pablintino/AnalogIO-CAN-HW/Fabrication/Schematic Print/Schematic Prints.PDF

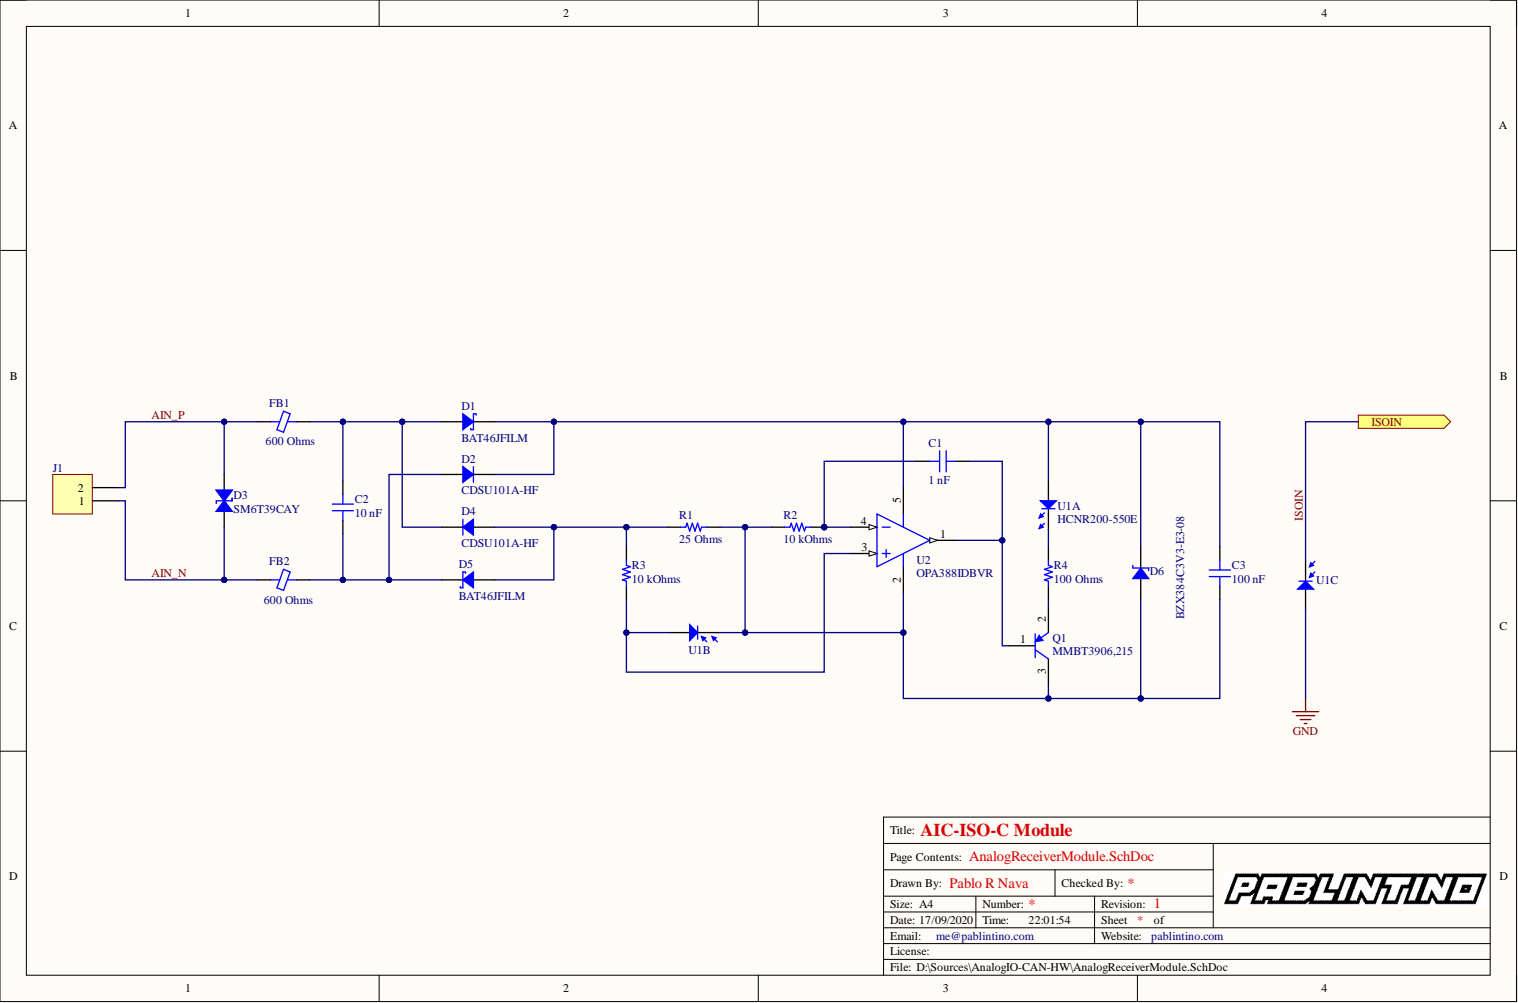
[picture p1: page 1]

Draw n By : P a blo R Na v a | Checked By : *
Size: A 4 | * N u mber: | 1 Rev i s i o n :

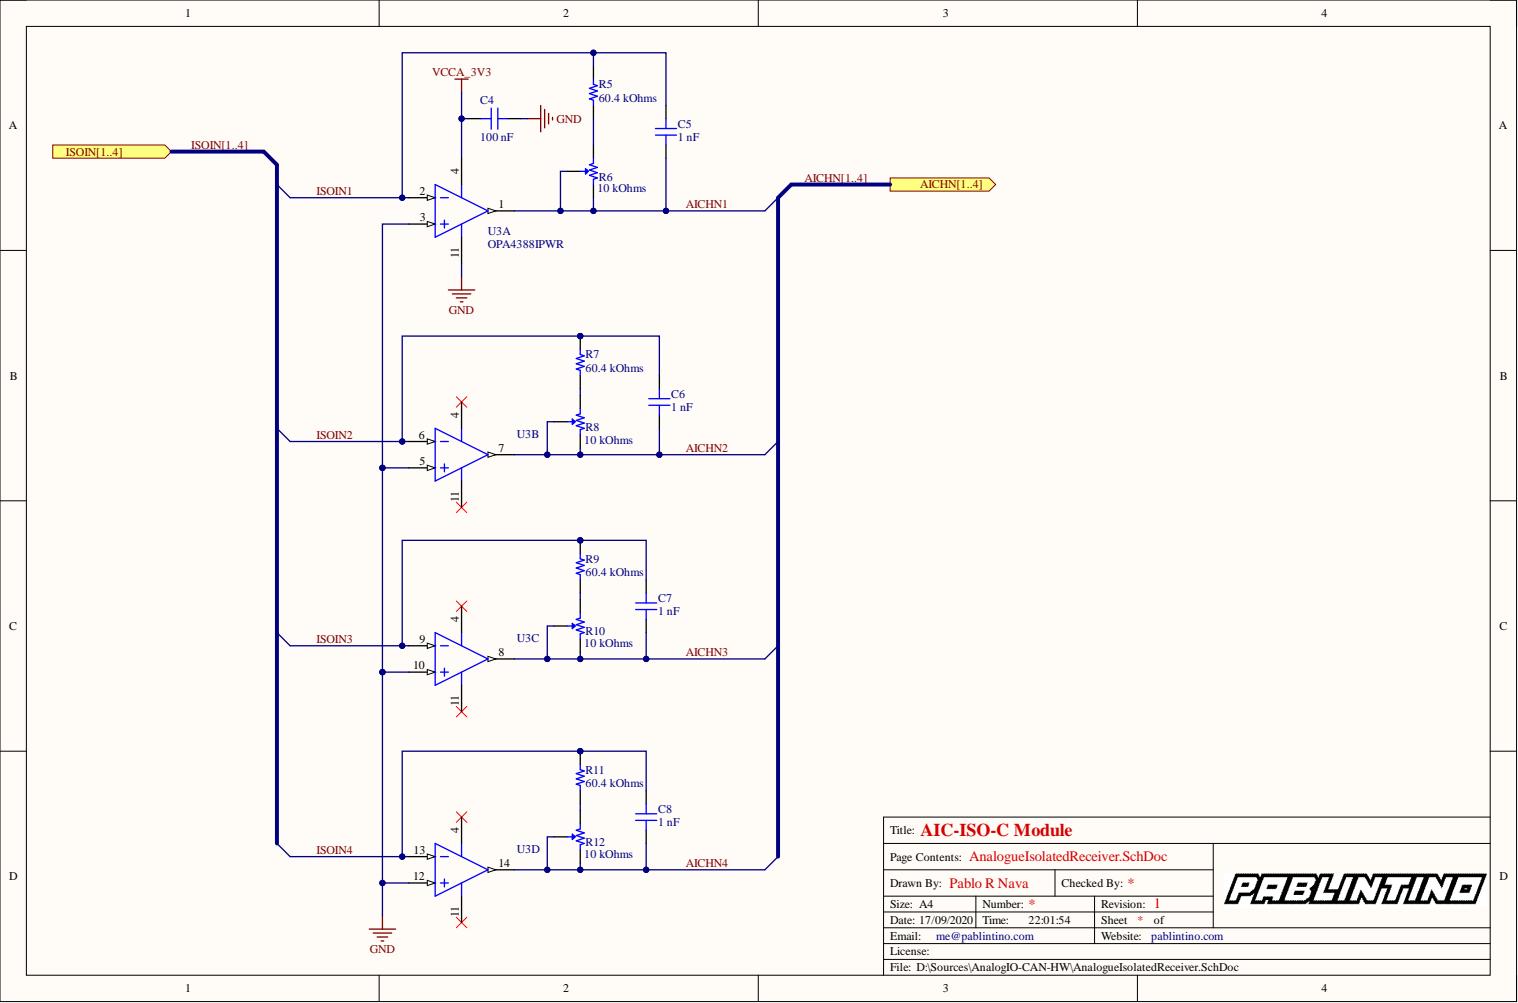
[picture p2: page 2]

Page Contents: AnalogueIsolatedReceiver.SchDoc

Drawn By: Pablo R Nava | Checked By: *
Size: A4 | * Number: | 1 Revision:

License:
D:\Sources\AnalogIO-CAN-HW\AnalogueIsolatedReceiver.SchDoc

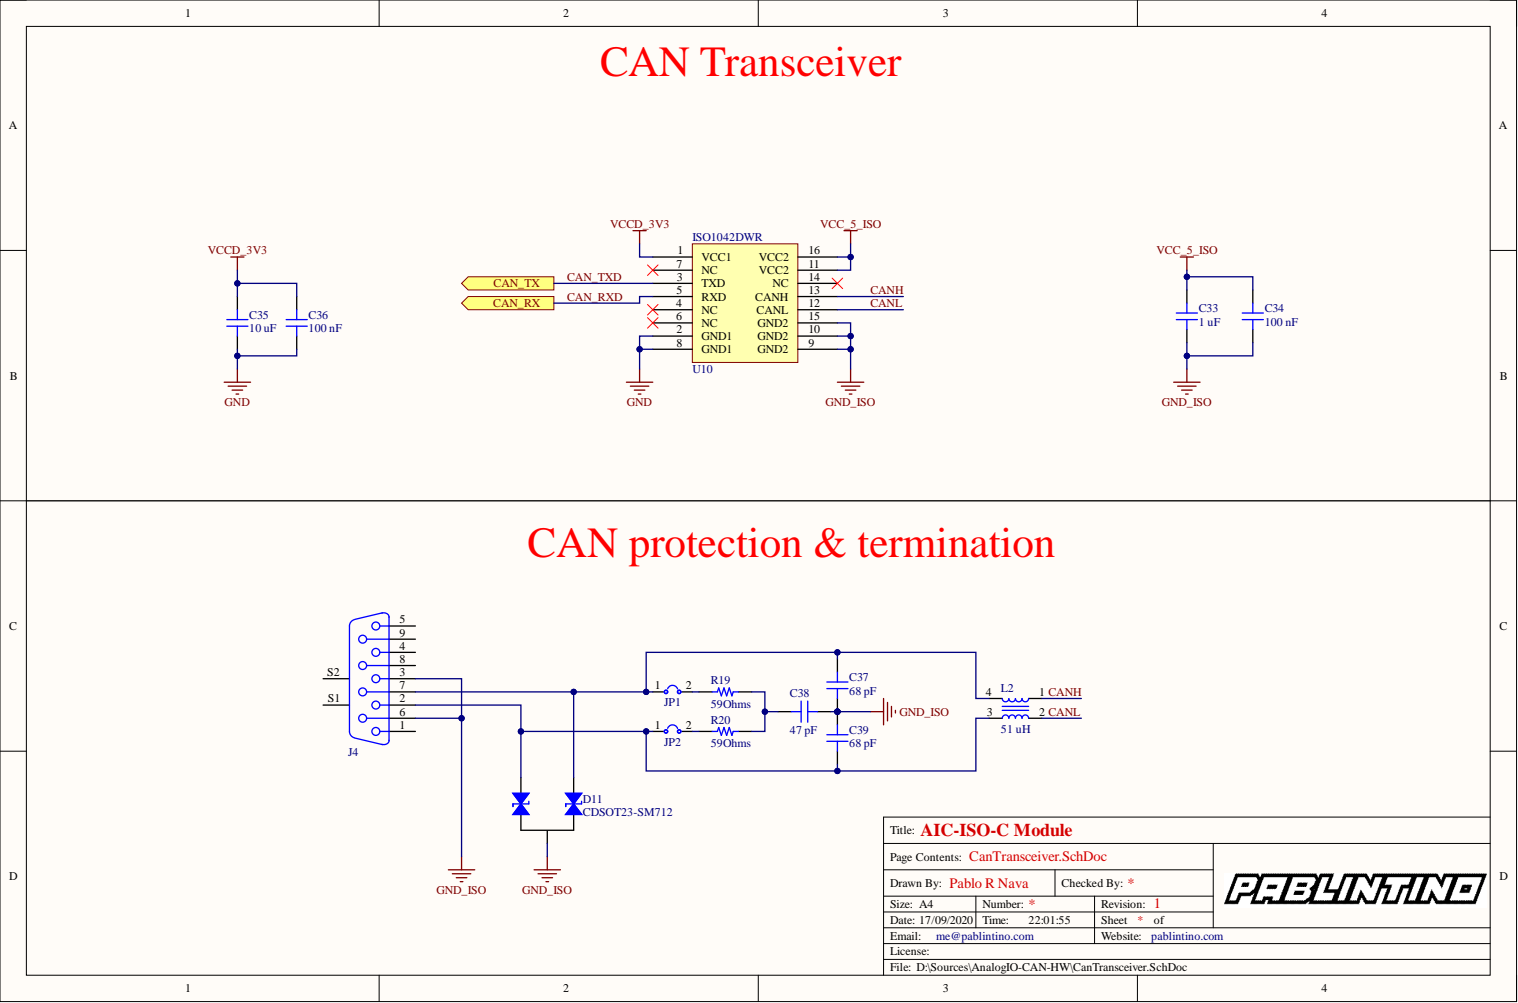
[picture p3: page 3]

JP2 59Ohms

Page Contents: CanTransceiver.SchDoc

Drawn By: Pablo R Nava | Checked By: *
Size: A4 | * Number: | 1 Revision:

D:\Sources\AnalogIO-CAN-HW\CanTransceiver.SchDoc

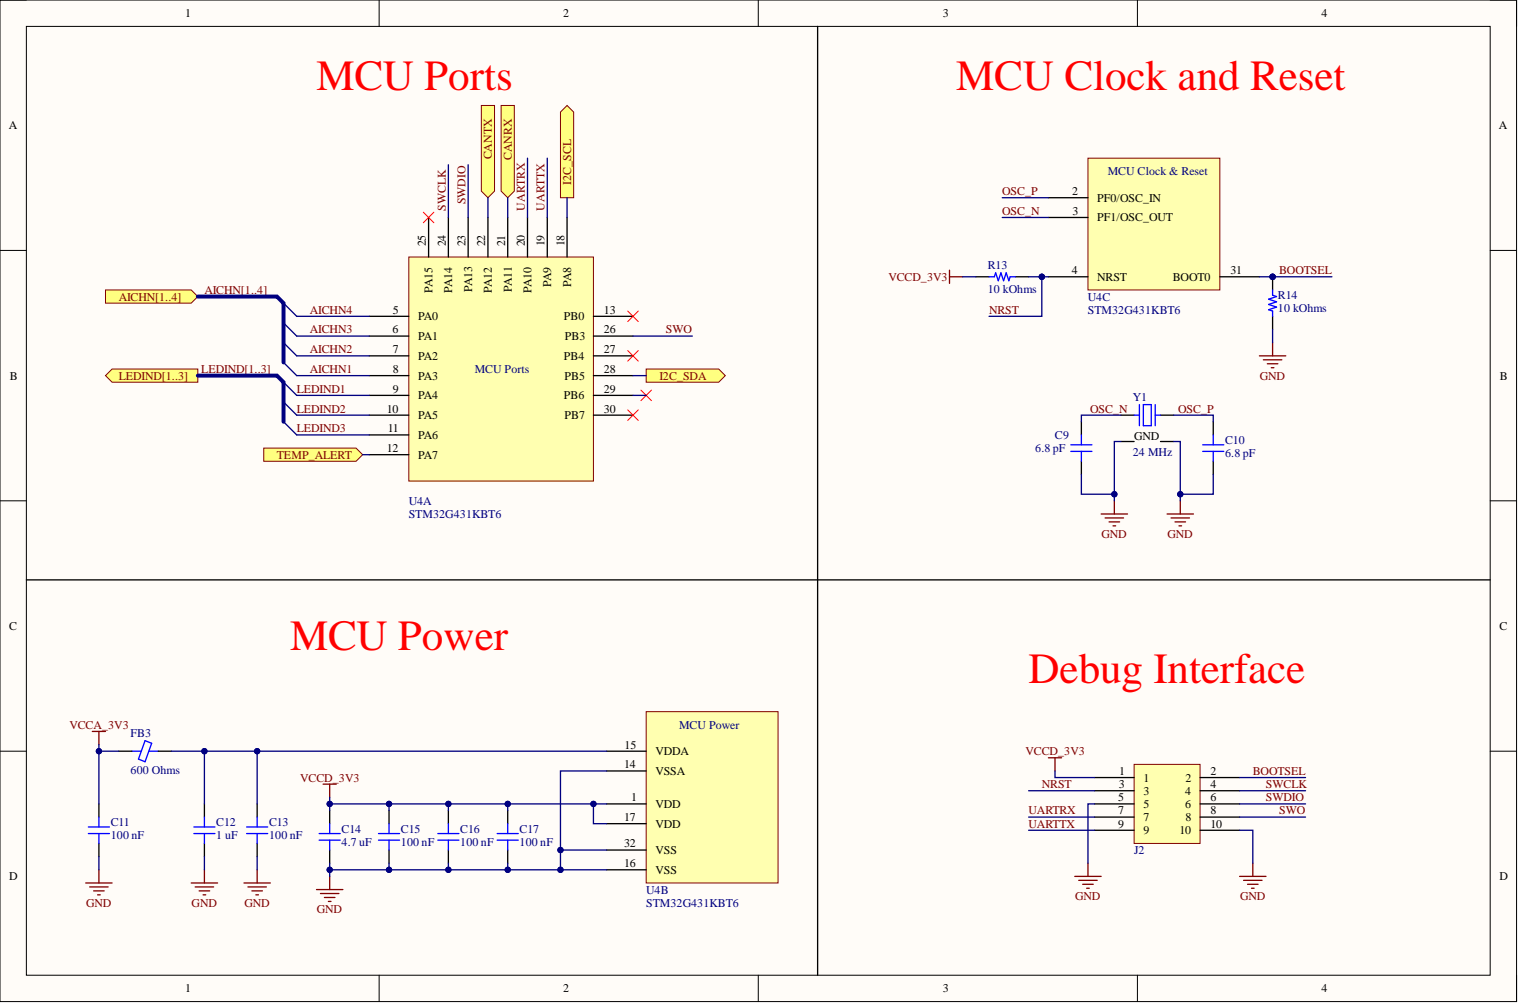
[picture p4: page 4]

MCU Clock and Reset

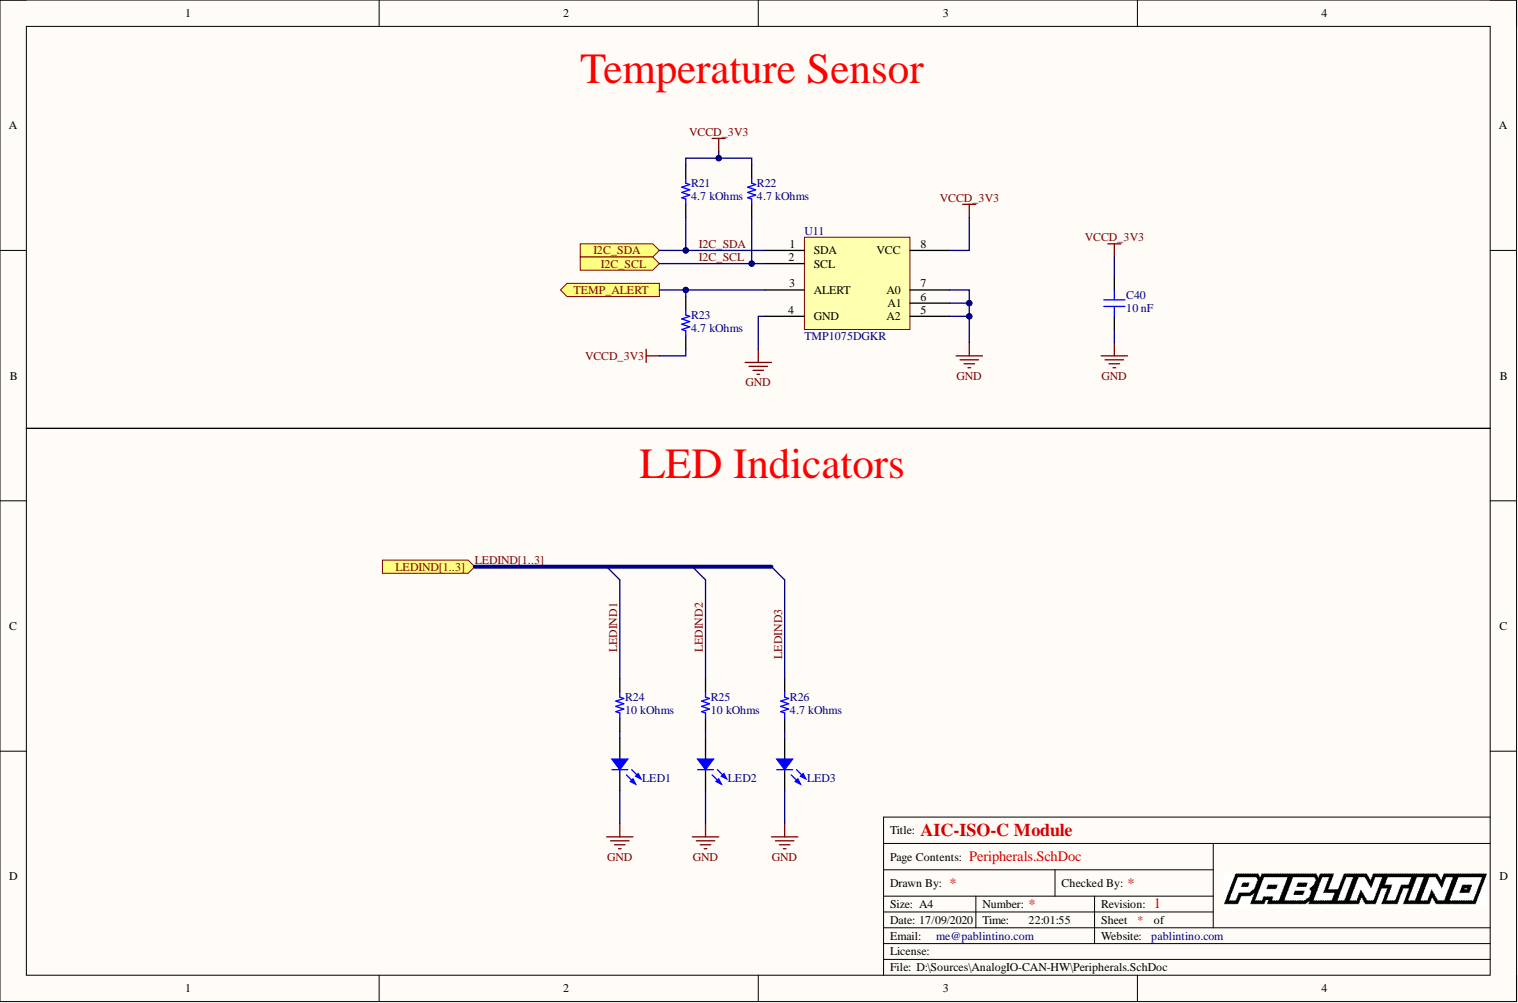
[picture p5: page 5]

Page Contents: Peripherals.SchDoc

Drawn By: * | Checked By: *
Size: A4 | * Number: | 1 Revision:

D:\Sources\AnalogIO-CAN-HW\Peripherals.SchDoc

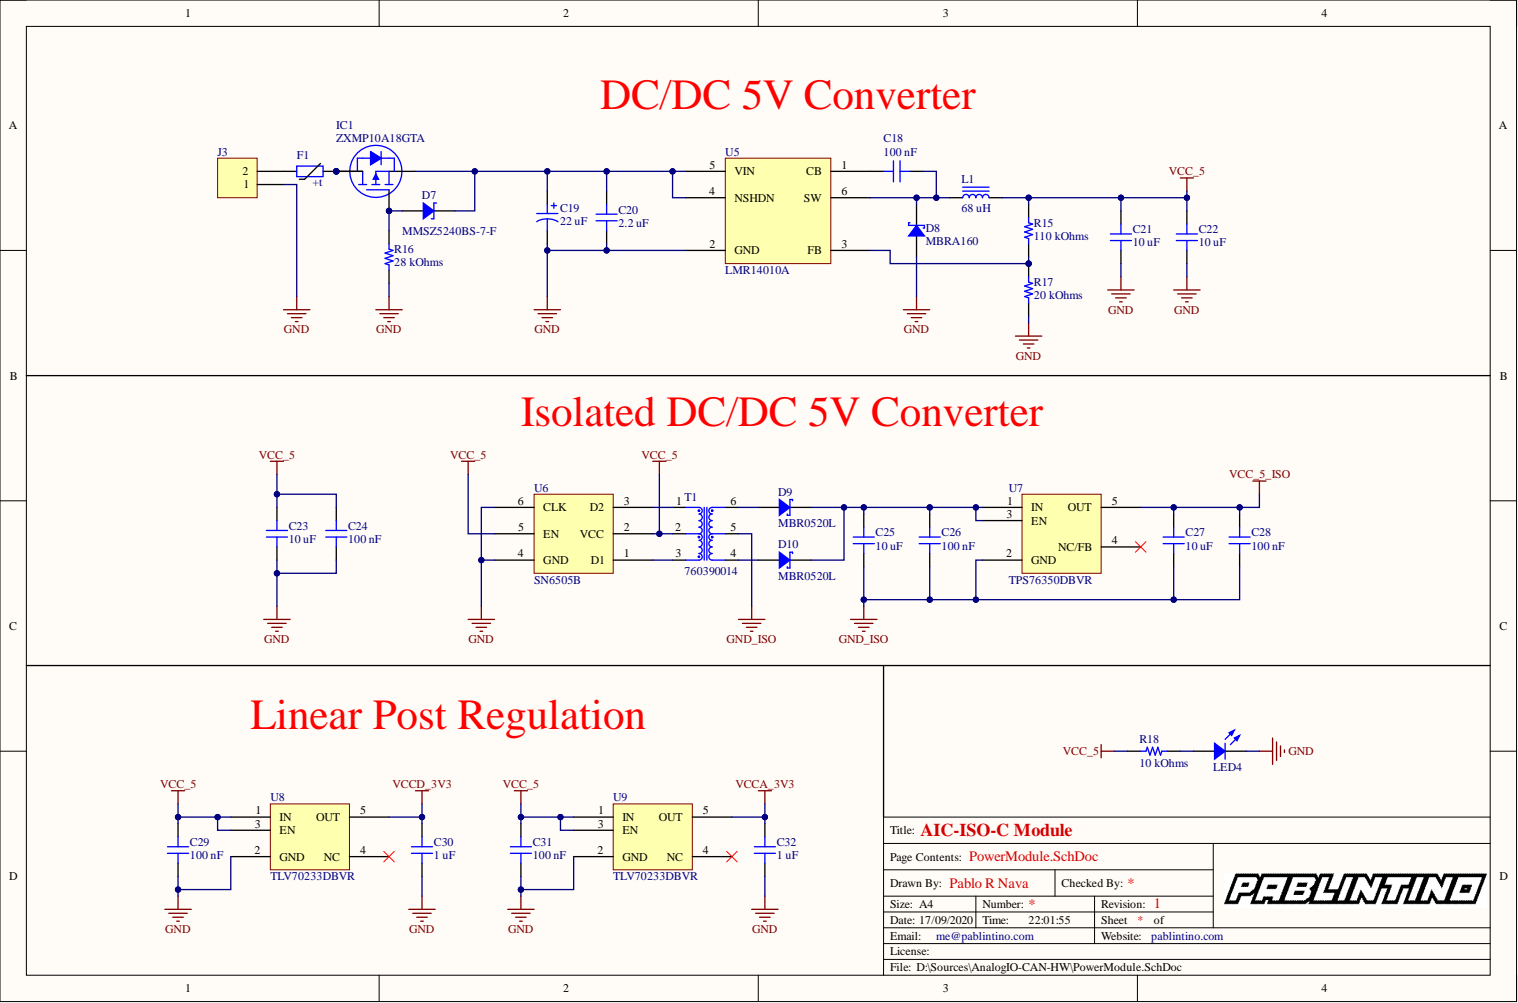
[picture p6: page 6]

GND
Isolated DC/DC 5V Converter

Page Contents: PowerModule.SchDoc

Drawn By: Pablo R Nava | Checked By: *
Size: A4 | * Number: | 1 Revision:

D:\Sources\AnalogIO-CAN-HW\PowerModule.SchDoc

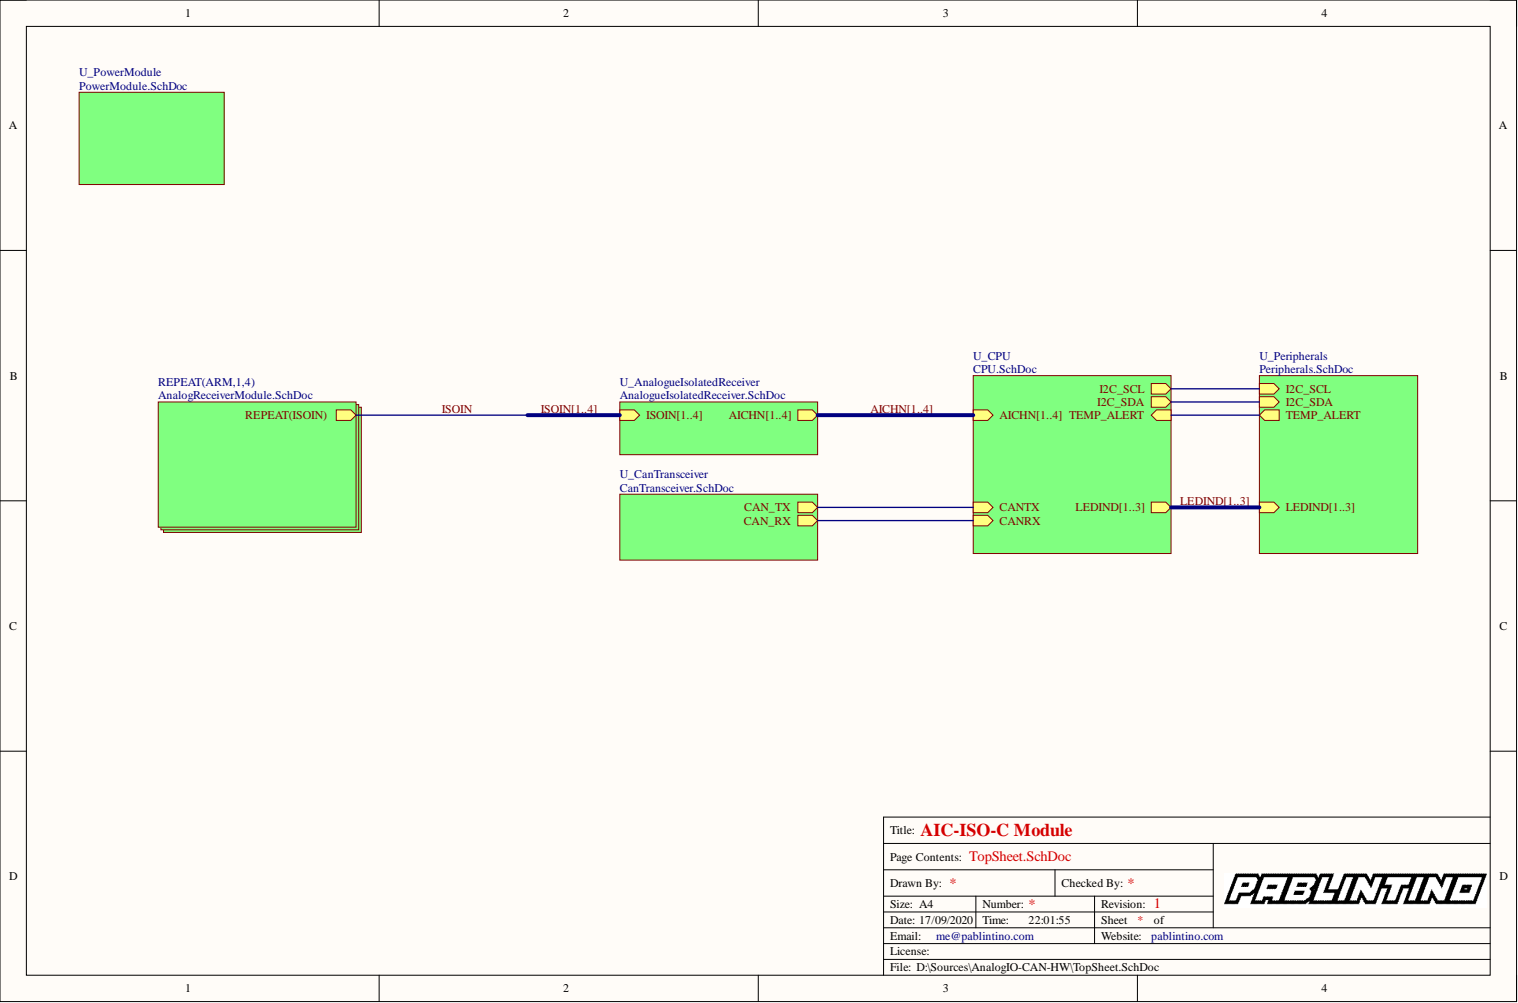
[picture p7: page 7]

Page Contents: TopSheet.SchDoc

Drawn By: * | Checked By: *
Size: A4 | * Number: | 1 Revision:

D:\Sources\AnalogIO-CAN-HW\TopSheet.SchDoc
