pablintino/AnalogIO-CAN-HW/Fabrication/DRC/Design Rules Check.PDF

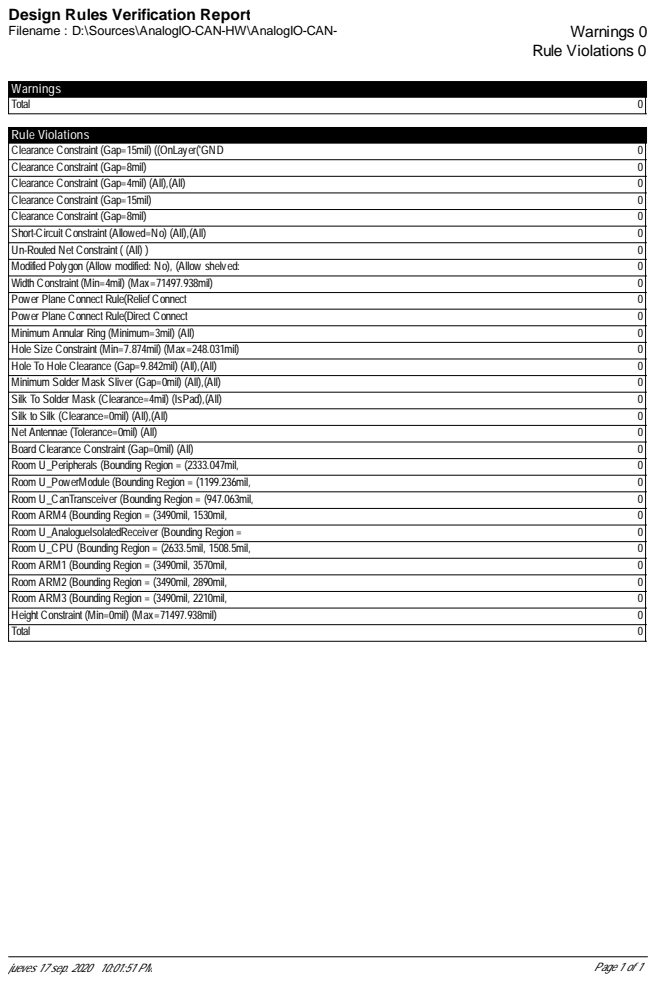
[picture p8: page 1]

Design Rules Verification Report
