pablintino/AnalogIO-CAN-HW/(list of files, drawings)

Other design files:
Altium_prj/AnalogIO-CAN-HW-Rev1.PcbDoc
AnalogReceiverModule.SchDoc
AnalogueIsolatedReceiver.SchDoc
CAN_CurrentLoopModule.PrjPcb
CANCurrentModuleLib.PcbLib
CANCurrentModuleLib.SchLib
CanTransceiver.SchDoc
CPU.SchDoc
Peripherals.SchDoc
PowerModule.SchDoc
TopSheet.SchDoc
