pablintino/AnalogIO-CAN-HW/(commit log)

2020-01-17 + Added first schematics
    [CANCurrentModuleLib.PcbLib, CANCurrentModuleLib.SchLib, CAN_CurrentLoopModule.PrjPcb, ModuleSchema.SchDoc]
2020-01-18 + Added power supply schematic
    [CANCurrentModuleLib.SchLib, ModuleSchema.SchDoc]
2020-01-18 + Added new analog schematic
    [AnalogReceiverModule.SchDoc, CANCurrentModuleLib.SchLib, CAN_CurrentLoopModule.PrjPcb, PowerModule.SchDoc]
2020-01-20 + Added analog current loop channel schematic input protection.
    [AnalogReceiverModule.SchDoc, CANCurrentModuleLib.SchLib, CAN_CurrentLoopModule.PrjPcb, PowerModule.SchDoc]
2020-01-20 + Added input ferrite beads to current sensing module.
    [AnalogReceiverModule.SchDoc, CANCurrentModuleLib.SchLib]
2020-01-25 + Changed VCC 3.3V net name. + Finished analog input circuit.
    [AnalogReceiverModule.SchDoc, AnalogueIsolatedReceiver.SchDoc, PowerModule.SchDoc, TopSheet.SchDoc]
2020-01-30 + Added CAN transceiver.
    [AnalogReceiverModule.SchDoc, CANCurrentModuleLib.SchLib, CAN_CurrentLoopModule.PrjPcb, CanTransceiver.SchDoc]
2020-02-02 + Added first revision of CPU Schematic.
    [CANCurrentModuleLib.SchLib, CPU.SchDoc, CanTransceiver.SchDoc, TopSheet.SchDoc]
2020-02-02 + First try on commponent designation.
    [AnalogReceiverModule.SchDoc, AnalogueIsolatedReceiver.SchDoc, CANCurrentModuleLib.SchLib, CAN_CurrentLoopModule.PrjPcb, CPU.SchDoc, CanTransceiver.SchDoc, Connectors.SchDoc, PowerModule.SchDoc]
2020-02-02 + Second revision of schematic.
    [AnalogReceiverModule.SchDoc, AnalogueIsolatedReceiver.SchDoc, CANCurrentModuleLib.SchLib, CAN_CurrentLoopModule.PrjPcb, CPU.SchDoc, CanTransceiver.SchDoc, PowerModule.SchDoc, TopSheet.SchDoc]
2020-02-02 + Cleanup.
    [Connectors.SchDoc, ModuleSchema.SchDoc]
2020-02-02 + First revision of the schematics that compiles.
    [AnalogReceiverModule.SchDoc, AnalogueIsolatedReceiver.SchDoc, CANCurrentModuleLib.SchLib, CAN_CurrentLoopModule.PrjPcb, CPU.SchDoc, CanTransceiver.SchDoc, PowerModule.SchDoc, TopSheet.SchDoc]
2020-02-02 + Minor name changes.
    [AnalogReceiverModule.SchDoc, TopSheet.SchDoc]
2020-02-06 + Added power schematic values. + Added third party parts with its footprints.
    [AnalogReceiverModule.SchDoc, AnalogueIsolatedReceiver.SchDoc, CANCurrentModuleLib.PcbLib, CPU.SchDoc, CanTransceiver.SchDoc, PowerModule.SchDoc]
2020-02-10 + Changed analog side components and its footprints.
    [AnalogReceiverModule.SchDoc, AnalogueIsolatedReceiver.SchDoc, CANCurrentModuleLib.PcbLib, CANCurrentModuleLib.SchLib, CAN_CurrentLoopModule.PrjPcb, CPU.SchDoc, CanTransceiver.SchDoc, PowerModule.SchDoc]
2020-02-11 + Added last footprints to the analog receiver part. + Changed default resistor values to the final values.
    [AnalogReceiverModule.SchDoc, CAN_CurrentLoopModule.PrjPcb]
2020-02-16 + Updated CAN module to use the new integrated lib symbols and footprints.
    [AnalogueIsolatedReceiver.SchDoc, CANCurrentModuleLib.PcbLib, CANCurrentModuleLib.SchLib, CAN_CurrentLoopModule.PrjPcb, CanTransceiver.SchDoc]
2020-02-16 + Added bypass capacitors to CAN module. + Adjusted termination to use 2 resistors and a cap. + Added recommended ferrites to VISO supply at the isolated side. + Changed global annotations.
    [AnalogReceiverModule.SchDoc, AnalogueIsolatedReceiver.SchDoc, CPU.SchDoc, CanTransceiver.SchDoc, PowerModule.SchDoc]
2020-02-16 + Fixed floating ground.
    [CanTransceiver.SchDoc]
2020-02-17 + Updated wrong values in Power module. + Updated caps in CPU module.
    [AnalogReceiverModule.SchDoc, AnalogueIsolatedReceiver.SchDoc, CPU.SchDoc, PowerModule.SchDoc]
2020-02-19 + Finished reverse voltage protection. + Changed inductor component to use the final one.
    [CAN_CurrentLoopModule.PrjPcb, PowerModule.SchDoc]
2020-02-23 + Changed LED and SPI memory components to use the common lib.
    [CANCurrentModuleLib.SchLib, CPU.SchDoc, PowerModule.SchDoc]
2020-02-24 + Fixed VCC, VDDA and XTAL caps + Changed MCU to the one from the common library
    [CANCurrentModuleLib.SchLib, CPU.SchDoc]
2020-02-27 + Added ABMM2 Crystal
    [CPU.SchDoc]
2020-02-28 + Updated last components (fuse, DSUB9 connector and temp sensor)
    [CPU.SchDoc, CanTransceiver.SchDoc, PowerModule.SchDoc]
2020-02-28 + Cleaned local lib.
    [CANCurrentModuleLib.SchLib]
2020-02-29 + Changed VCC input protection MOSFET to a more apropiate one
    [CAN_CurrentLoopModule.PrjPcb]
2020-02-29 + Input MOSFET changed + Added PCB document
    [AnalogReceiverModule.SchDoc, PowerModule.SchDoc]
2020-03-01 + Partial routing and placement of PSU, CAN Transceiver and Analog Channel 1
    [CAN_CurrentLoopModule.PrjPcb]
2020-03-01 + ROOMs adjusted
    [CAN_CurrentLoopModule.PrjPcb, CanTransceiver.SchDoc, TopSheet.SchDoc]
2020-03-01 + Analog side placemnt and routin improvements
    [AnalogReceiverModule.SchDoc]
2020-03-02 + Fixed CAN ground missconnection.
    [CanTransceiver.SchDoc]
2020-03-04 + Changed JTAG and UART connector + Changed placement
    [CPU.SchDoc]
2020-03-05 + New routing and placement
    [AnalogReceiverModule.SchDoc]
2020-03-10 + Finished placing and general (non-power) routing.
2020-03-11 + CPU SPI pin swap with ANALOG input to allow SWO pin to be non-shared with SPI SCK.
    [CPU.SchDoc, TopSheet.SchDoc]
2020-03-14 + Intermediate up.
    [CPU.SchDoc]
2020-03-15 + New CPU placement + Rerouted CPU + Fixed some issues in PSU module regarding RUN pin + Finished CAN transceiver
    [CPU.SchDoc, PowerModule.SchDoc]
2020-03-15 + Final touches
    [CPU.SchDoc]
2020-03-15 + Added all polygon pours + Finished routing + Mounting holes placed
2020-03-16 + First gerber generation of REV 0.
    [CAN_CurrentLoopModule.PrjPcb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]
2020-03-17 + Planes and shape revision. + Changed mounting holes plating. + Generated Fabrication Job.
    [Bill of Materials-CAN_CurrentLoopModule.xlsx, CAN_CurrentLoopModule.PrjPcb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]
2020-03-17 + Fixed some dead copper.
    [Bill of Materials-CAN_CurrentLoopModule.xlsx, CAN_CurrentLoopModule.PrjPcb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]
2020-03-17 + Fixed project file to remove unwanted output files.
    [CAN_CurrentLoopModule.PrjPcb]
2020-03-18 + Fixed distances between pad/via/trace and GND pours.
    [Bill of Materials-CAN_CurrentLoopModule.xlsx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]
2020-03-24 + Updated component values.
    [AnalogReceiverModule.SchDoc, PowerModule.SchDoc]
2020-06-24 Changed master to start Rev 1 hardware design
    [AnalogReceiverModule.SchDoc, AnalogueIsolatedReceiver.SchDoc, CAN_CurrentLoopModule.PrjPcb, CPU.SchDoc, CanTransceiver.SchDoc, Peripherals.SchDoc, PowerModule.SchDoc, TopSheet.SchDoc]
2020-07-09 Partial commit of Rev 1 redesign
    [AnalogReceiverModule.SchDoc, CanTransceiver.SchDoc, PowerModule.SchDoc]
2020-07-19 First schematic version of REV 1.0
    [AnalogReceiverModule.SchDoc, AnalogueIsolatedReceiver.SchDoc, CAN_CurrentLoopModule.PrjPcb, CPU.SchDoc, CanTransceiver.SchDoc, Peripherals.SchDoc, PowerModule.SchDoc, TopSheet.SchDoc]
2020-07-19 Added REV1 PCB Design and fixed old library references
    [AnalogIO-CAN-HW-Rev1.PcbDoc, AnalogReceiverModule.SchDoc, AnalogueIsolatedReceiver.SchDoc, CAN_CurrentLoopModule.PrjPcb, CPU.SchDoc, CanTransceiver.SchDoc, PowerModule.SchDoc]
2020-07-21 + More placement done. + Replaced LDOs with a P/N that is available in SOT-23.
    [AnalogIO-CAN-HW-Rev1.PcbDoc, AnalogueIsolatedReceiver.SchDoc, CAN_CurrentLoopModule.PrjPcb, CanTransceiver.SchDoc, PowerModule.SchDoc]
2020-07-22 + First placement revision. + Fixed HCNR200 polarity
    [AnalogIO-CAN-HW-Rev1.PcbDoc, AnalogReceiverModule.SchDoc, CPU.SchDoc, Peripherals.SchDoc]
2020-07-24 Added routing for PSU, CPU and the analog side
    [AnalogReceiverModule.SchDoc, AnalogueIsolatedReceiver.SchDoc, CPU.SchDoc, CanTransceiver.SchDoc, Peripherals.SchDoc, PowerModule.SchDoc, TopSheet.SchDoc]
2020-07-26 + Added more progess in PCB routing. + Replaced discrete LED transistors.
    [AnalogReceiverModule.SchDoc, AnalogueIsolatedReceiver.SchDoc, CAN_CurrentLoopModule.PrjPcb, CPU.SchDoc, CanTransceiver.SchDoc, Peripherals.SchDoc, PowerModule.SchDoc, TopSheet.SchDoc]
2020-07-26 First Revision 1 full routing iteration
    [AnalogReceiverModule.SchDoc, AnalogueIsolatedReceiver.SchDoc, CPU.SchDoc, CanTransceiver.SchDoc, Peripherals.SchDoc, PowerModule.SchDoc, TopSheet.SchDoc]
2020-07-26 Second Revision 1 full routing iteration. Changed back the XTAL selection and fixed cap values. Added a GND guard and local plane around the XTAL. Added board name and author. Moved ground plane just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
    [AnalogReceiverModule.SchDoc, AnalogueIsolatedReceiver.SchDoc, CPU.SchDoc, CanTransceiver.SchDoc, Peripherals.SchDoc, PowerModule.SchDoc]
2020-07-27 Third iteration of Revision 1 board. Changed 5V buck converter placement. Modified potentiometers silkscreen. Added thermal bias to DC/DC modules
    [AnalogReceiverModule.SchDoc, AnalogueIsolatedReceiver.SchDoc, CPU.SchDoc, CanTransceiver.SchDoc, Peripherals.SchDoc, PowerModule.SchDoc, TopSheet.SchDoc]
2020-07-27 Replaced some ADC pin asigments to improve routing
    [CPU.SchDoc]
2020-07-29 Added another iteration over Revision 1
    [AnalogReceiverModule.SchDoc, AnalogueIsolatedReceiver.SchDoc, CAN_CurrentLoopModule.PrjPcb, CPU.SchDoc, CanTransceiver.SchDoc, Peripherals.SchDoc, PowerModule.SchDoc, TopSheet.SchDoc]
2020-07-30 Improved 3D models. Added mounting holes. Fixed power and GND planes connection style
2020-08-19 Added pre-release iteration of the Rev 1 board
    [AnalogReceiverModule.SchDoc, AnalogueIsolatedReceiver.SchDoc, Bill of Materials-CAN_CurrentLoopModule.xlsx, CAN_CurrentLoopModule.PrjPcb, CPU.SchDoc, CanTransceiver.SchDoc, Peripherals.SchDoc, PowerModule.SchDoc]
2020-08-20 Rev 1 board pre-release design. Changed opamps to low offset ones and fixed inner planes connection styles.
    [AnalogReceiverModule.SchDoc, AnalogueIsolatedReceiver.SchDoc, Bill of Materials-CAN_CurrentLoopModule.xlsx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]
2020-08-20 Added Rev 1 fabrication files
    [AnalogIO-CAN-HW-Rev1.GBL, AnalogIO-CAN-HW-Rev1.GBO, AnalogIO-CAN-HW-Rev1.GBP, AnalogIO-CAN-HW-Rev1.GBS, AnalogIO-CAN-HW-Rev1.GKO, AnalogIO-CAN-HW-Rev1.GTL, AnalogIO-CAN-HW-Rev1.GTO, AnalogIO-CAN-HW-Rev1.GTP]
2020-08-20 Folder reestructure
    [AnalogIO-CAN-HW-Rev1.GBL, AnalogIO-CAN-HW-Rev1.GBO, AnalogIO-CAN-HW-Rev1.GBP, AnalogIO-CAN-HW-Rev1.GBS, AnalogIO-CAN-HW-Rev1.GKO, AnalogIO-CAN-HW-Rev1.GTL, AnalogIO-CAN-HW-Rev1.GTO, AnalogIO-CAN-HW-Rev1.GTP]
2020-08-21 Minor fixes in top overlay
    [AnalogIO-CAN-HW-Rev1.GBL, AnalogIO-CAN-HW-Rev1.GBO, AnalogIO-CAN-HW-Rev1.GBP, AnalogIO-CAN-HW-Rev1.GBS, AnalogIO-CAN-HW-Rev1.GKO, AnalogIO-CAN-HW-Rev1.GTL, AnalogIO-CAN-HW-Rev1.GTO, AnalogIO-CAN-HW-Rev1.GTP]
2020-08-21 Fixed LDOs power connection to inner planes
    [AnalogIO-CAN-HW-Rev1.GBL, AnalogIO-CAN-HW-Rev1.GBO, AnalogIO-CAN-HW-Rev1.GBP, AnalogIO-CAN-HW-Rev1.GBS, AnalogIO-CAN-HW-Rev1.GKO, AnalogIO-CAN-HW-Rev1.GTL, AnalogIO-CAN-HW-Rev1.GTO, AnalogIO-CAN-HW-Rev1.GTP]
2020-08-21 Added Schematic to fabrication output
    [CAN_CurrentLoopModule.PrjPcb]
2020-08-21 Fixed BOM format in order to group components only by their part number
    [Bill of Materials-CAN_CurrentLoopModule.xlsx]
2020-09-02 Changed C40 to an X7R cap
    [Bill of Materials-CAN_CurrentLoopModule.xlsx, Peripherals.SchDoc]
2020-09-13 Fixed some resistor values after testing REV1 board. Amplifier resistors has been changed to 56k instead of 63k in order to allow a less gain. Red LED resistor changed to cause brigthness is too low
    [AnalogueIsolatedReceiver.SchDoc, Bill of Materials-CAN_CurrentLoopModule.xlsx, Peripherals.SchDoc]
2020-09-17 Amplifier resistors has been changed to 60.4k instead of 56k in order to allow a less gain.
    [AnalogueIsolatedReceiver.SchDoc, Bill of Materials-CAN_CurrentLoopModule.xlsx]
